thomasschoenfeld/GoBe/Cage_Plate_VZHex_v2.stl

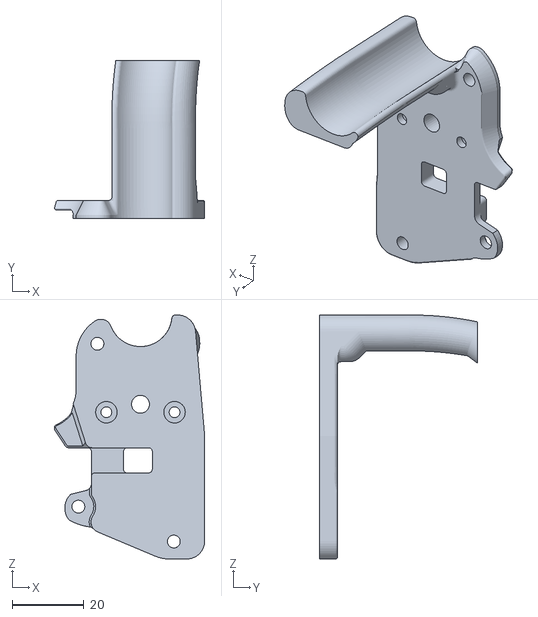
[picture p17: CAD file, 2024-02-20]
Cage_Plate_VZHex_v2.stl
41.9 x 44.0 x 68.0
