thomasschoenfeld/GoBe/GoBe_toolead_v1.9.1.stl

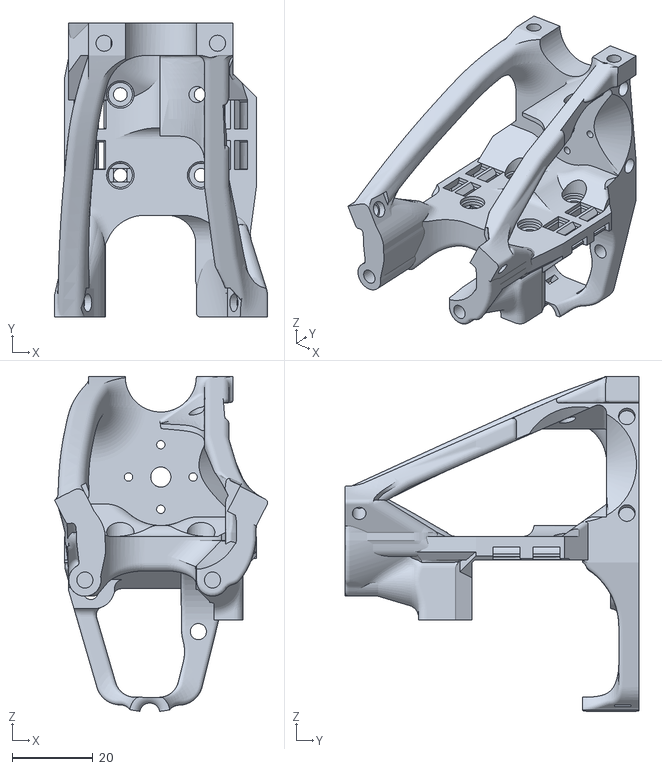
[picture p18: CAD file, 2024-02-20]
GoBe_toolead_v1.9.1.stl
52.8 x 72.8 x 82.9
