thomasschoenfeld/GoBe/Cage_Umbilical_v2.1.stl

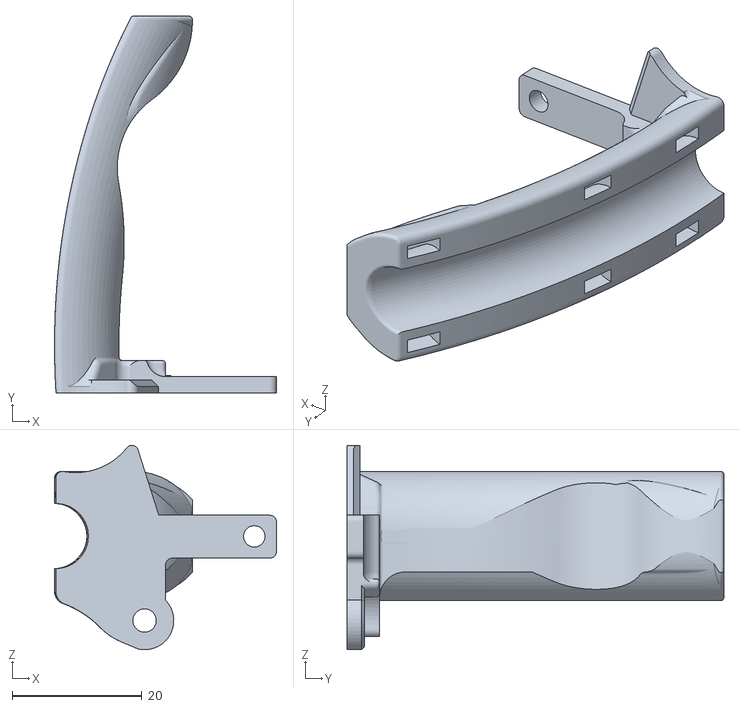
[picture p19: CAD file, 2024-02-20]
Cage_Umbilical_v2.1.stl
34.2 x 58.0 x 31.4
