thomasschoenfeld/GoBe/GoBe_toolead_v1.9.0_wKlicky_and_support.stl

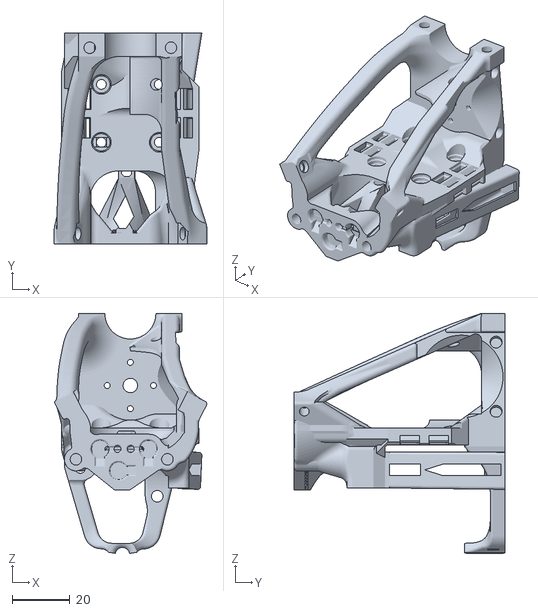
[picture p20: CAD file, 2023-03-26]
GoBe_toolead_v1.9.0_wKlicky_and_support.stl
52.8 x 72.8 x 82.9
