thomasschoenfeld/GoBe/GoBe_toolead_v1.9.0_w_Klicky_support_required.stl

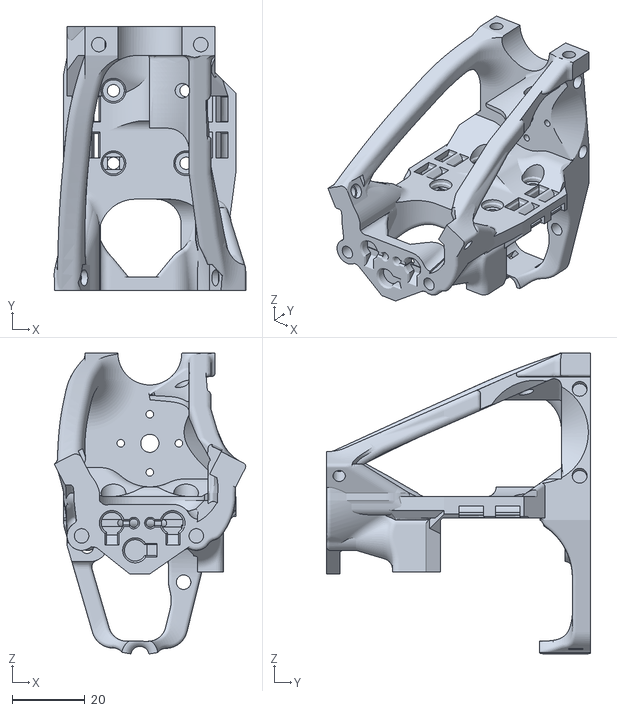
[picture p21: CAD file, 2023-03-26]
GoBe_toolead_v1.9.0_w_Klicky_support_required.stl
52.8 x 72.8 x 82.9
