thomasschoenfeld/GoBe/Hex_Cage_Support_v2.stl

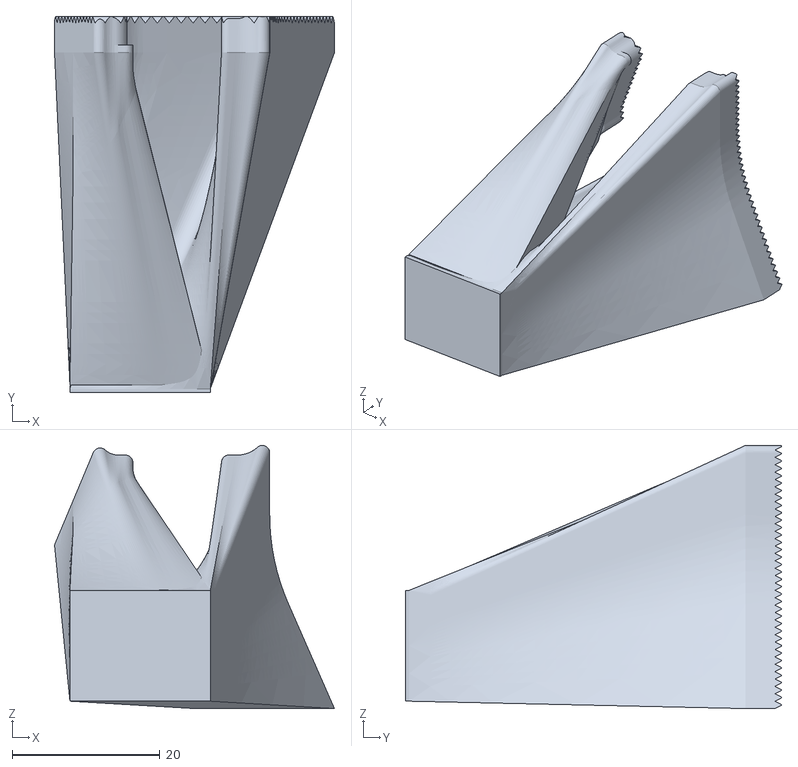
[picture p22: CAD file, 2023-03-26]
Hex_Cage_Support_v2.stl
37.9 x 50.9 x 35.6
