thomasschoenfeld/GoBe/Hex_adapter_w_cage.stl

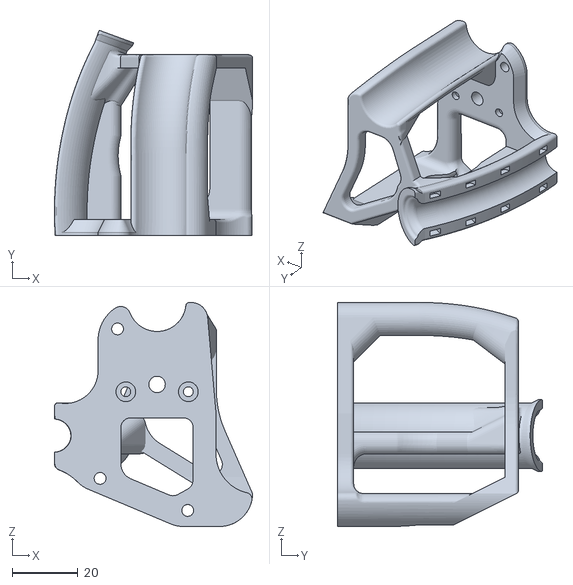
[picture p23: CAD file, 2023-03-25]
Hex_adapter_w_cage.stl
60.2 x 62.4 x 68.0
