thomasschoenfeld/GoBe/HEx-adapter_v3.1.stl

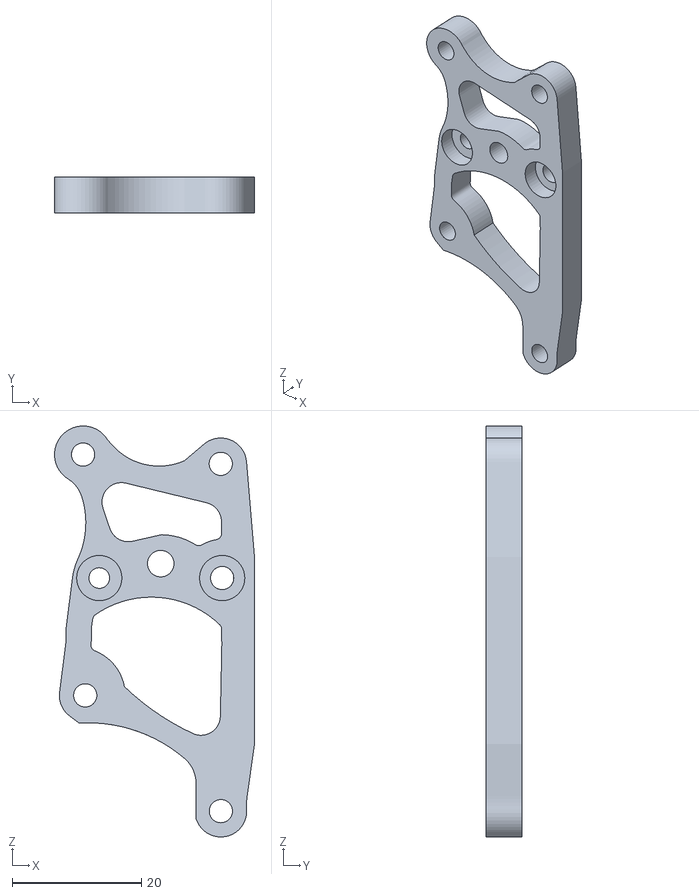
[picture p24: CAD file, 2023-03-23]
HEx-adapter_v3.1.stl
30.9 x 5.50 x 63.5
