thomasschoenfeld/GoBe/GoBe_toolead_v1.8.2_wSupport.stl

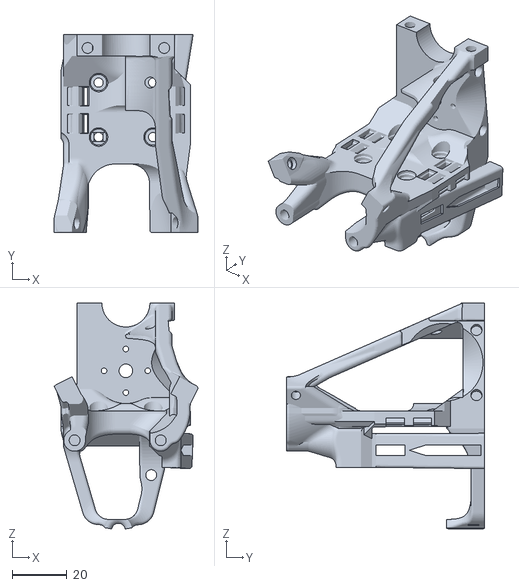
[picture p25: CAD file, 2023-03-23]
GoBe_toolead_v1.8.2_wSupport.stl
52.8 x 72.8 x 82.9
