thomasschoenfeld/GoBe/Duct_v6.3.stl

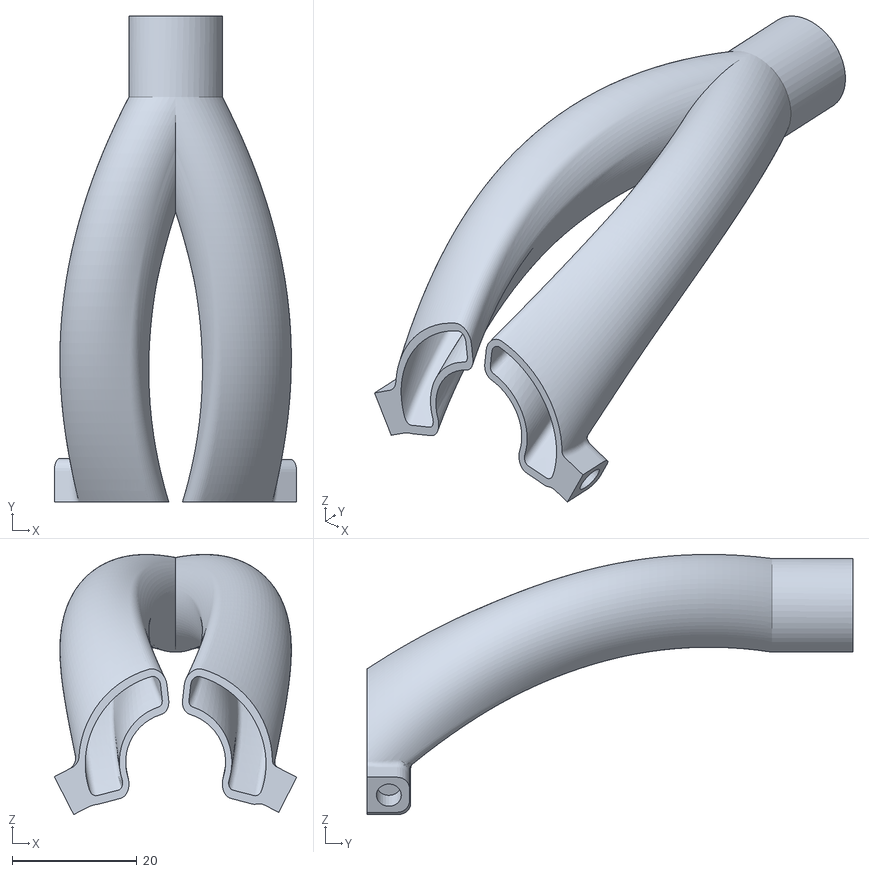
[picture p26: CAD file, 2023-03-20]
Duct_v6.3.stl
38.8 x 77.8 x 41.6
