thomasschoenfeld/GoBe/GoBe_toolead_v1.7_Voron2.4 CF rod MOD v71_HEx-adapter_v2.stl

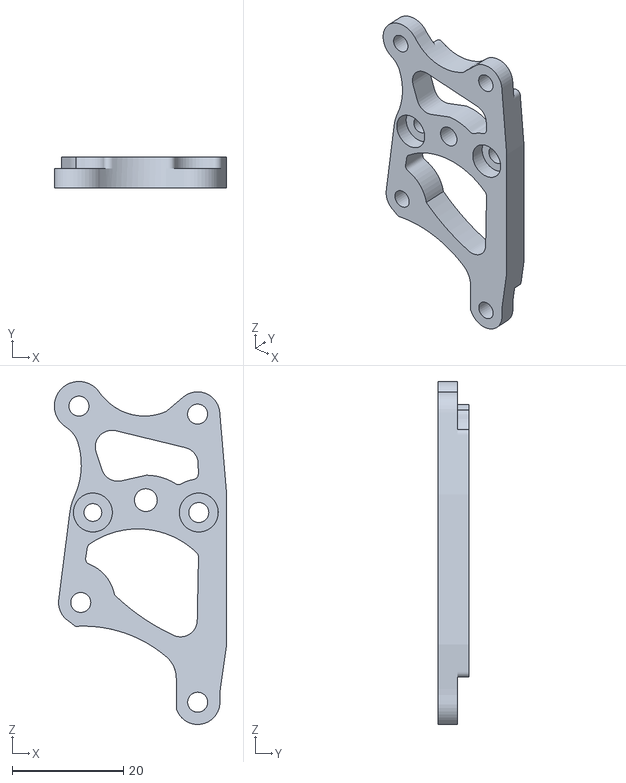
[picture p27: CAD file, 2023-03-19]
GoBe_toolead_v1.7_Voron2.4 CF rod MOD v71_HEx-adapter_v2.stl
30.9 x 5.50 x 61.5
