thomasschoenfeld/GoBe/GoBe_toolead_v1.7_Voron2.4 CF rod MOD v71_Umbilical_cord_3.0.stl

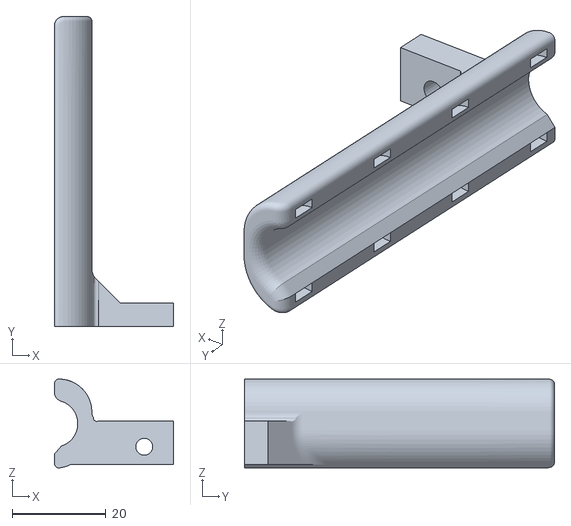
[picture p28: CAD file, 2023-03-19]
GoBe_toolead_v1.7_Voron2.4 CF rod MOD v71_Umbilical_cord_3.0.stl
25.4 x 66.0 x 18.9
