thomasschoenfeld/GoBe/Goliath_FYI.stl

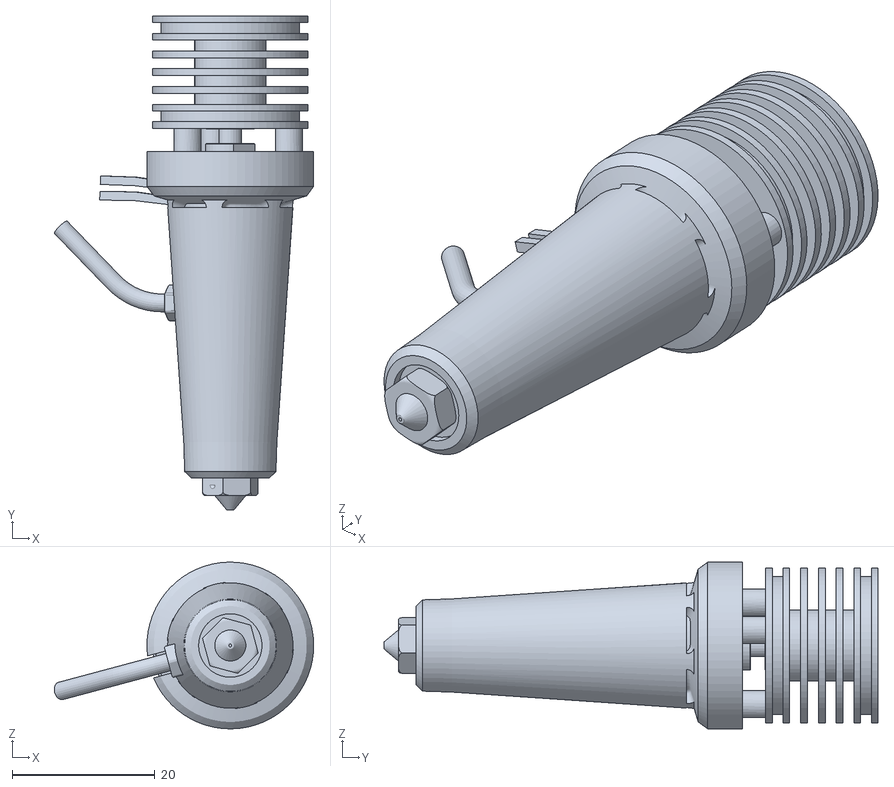
[picture p29: CAD file, 2023-03-19]
Goliath_FYI.stl
36.4 x 69.3 x 23.4
