thomasschoenfeld/GoBe/Clamp_v3.0.stl

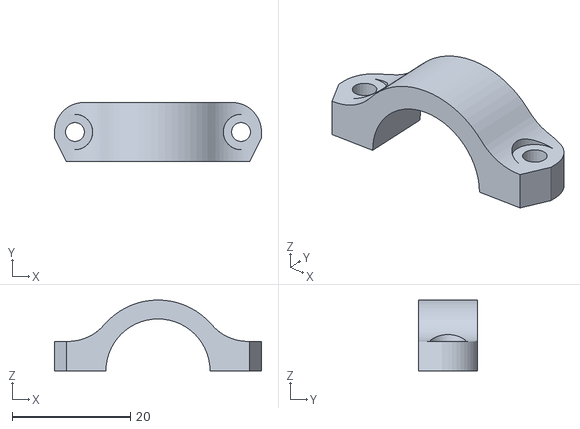
[picture p30: CAD file, 2023-03-19]
Clamp_v3.0.stl
35.0 x 10.0 x 12.0
