thomasschoenfeld/GoBe/(list of files, cad)

Other CAD files:
GoBe_toolead_v1.9.0_w_support.stl
older_version/GoBe_toolead_v1.8.1_w_support.stl
GoBe_toolead_v1.8.1_w_support.stl
GoBe_toolead_v1.8.2.stl
GoBe_toolead_v1.9.0.stl
older_version/Clamp_4.1_w_ADXL_mount.stl
older_version/Clamp_w_ADXL_mount.stl
older_version/GoBe_toolead_v1.3.stl
older_version/GoBe_toolead_v1.6.stl
older_version/GoBe_toolead_v1.7_Voron2.4 CF rod MOD v71_GoBe_toolead_v1.7.stl
older_version/GoBe_toolead_v1.7_Voron2.4 CF rod MOD v71_Klicky_toolhead_v1.7.stl
older_version/GoBe_toolead_v1.8.2.stl
older_version/GoBe_toolhead_v1.0_Voron2.4 CF rod MOD v18_3010_fan.stl
older_version/GoBe_toolhead_v1.0_Voron2.4 CF rod MOD v18_Clamp_3.0.stl
older_version/GoBe_toolhead_v1.0_Voron2.4 CF rod MOD v18_DUCT_v5.5.stl
older_version/GoBe_toolhead_v1.0_Voron2.4 CF rod MOD v18_GoBe_toolead_v1.1.stl
older_version/GoBe_toolhead_v1.0_Voron2.4 CF rod MOD v18_Goliath.stl
older_version/GoBe_toolhead_v1.0_Voron2.4 CF rod MOD v18_HEx-adapter_v2.stl
older_version/GoBe_toolhead_v1.0_Voron2.4 CF rod MOD v18_Umbilical_cord_3.0.stl
