thomasschoenfeld/GoBe/(commit log)

2023-03-16 toolhead updated
    [GoBe_toolhead_v1.0_Voron2.4 CF rod MOD v18_3010_fan.stl, GoBe_toolhead_v1.0_Voron2.4 CF rod MOD v18_Clamp_3.0.stl, GoBe_toolhead_v1.0_Voron2.4 CF rod MOD v18_DUCT_v5.5.stl, GoBe_toolhead_v1.0_Voron2.4 CF rod MOD v18_GoBe_toolead_v1.1.stl, GoBe_toolhead_v1.0_Voron2.4 CF rod MOD v18_Goliath.stl, GoBe_toolhead_v1.0_Voron2.4 CF rod MOD v18_HEx-adapter_v2.stl, GoBe_toolhead_v1.0_Voron2.4 CF rod MOD v1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]
2023-03-16 modified geometry
    [GoBe_toolead_v1.3.stl]
2023-03-19 improver version
    [Clamp_4.1_w_ADXL_mount.stl, Clamp_w_ADXL_mount.stl, GoBe_toolead_v1.3.stl, GoBe_toolead_v1.6.stl, GoBe_toolead_v1.7_Voron2.4 CF rod MOD v71_3010_fan.stl, GoBe_toolead_v1.7_Voron2.4 CF rod MOD v71_Clamp_3.0.stl, GoBe_toolead_v1.7_Voron2.4 CF rod MOD v71_Clamp_4.1_w_ADXL_mount.stl, GoBe_toolead_v1.7_Voron2.4 CF rod MOD v71_DUCT_v6.0.stl]
2023-03-20 improved hotend cooling
    [GoBe_toolead_v1.7.1.stl, Klicky_toolhead_v1.7.1.stl]
2023-03-20 updated hotend cooling
    [GoBe_toolead_v1.7_Voron2.4 CF rod MOD v71_GoBe_toolead_v1.7.stl, GoBe_toolead_v1.7_Voron2.4 CF rod MOD v71_Klicky_toolhead_v1.7.stl]
2023-03-20 slightly updated duct
    [Duct_v6.3.stl, GoBe_toolead_v1.7.1.stl, GoBe_toolead_v1.7.2.stl, GoBe_toolead_v1.7_Voron2.4 CF rod MOD v71_DUCT_v6.0.stl, Klicky_toolhead_v1.7.1.stl, Klicky_toolhead_v1.7.2.stl]
2023-03-20 added print support structures
    [GoBe_klicky_v1.7.3_w_print_support.stl, GoBe_toolead_v1.7.2.stl, GoBe_toolead_v1.7.3.stl, GoBe_toolead_v1.7.3_with_support.stl, Klicky_toolhead_v1.7.2.stl, Klicky_toolhead_v1.7.3.stl]
2023-03-23 v1.8 with multiple improvements
    [GoBe_toolead_v1.8.1_w_support.stl, GoBe_toolead_v1.8.2.stl, GoBe_toolead_v1.8.2_wSupport.stl, HEx-adapter_v3.1.stl]
2023-03-23 uploaded fusion file
    [GoBe_klicky_v1.7.3_w_print_support.stl, GoBe_toolead_v1.7.3.stl, GoBe_toolead_v1.7.3_with_support.stl, Klicky_toolhead_v1.7.3.stl]
2023-03-25 stronger top cage added
    [GoBe_toolead_v1.7_Voron2.4 CF rod MOD v71_Clamp_4.1_w_ADXL_mount.stl, GoBe_toolead_v1.9.0.stl, GoBe_toolead_v1.9.0_w_support.stl, Hex_Cage_Support1.stl, Hex_adapter_w_cage.stl]
2023-03-25 updates readme and pictures
    [Clamp_v3.0.stl, GoBe_toolead_v1.7_Voron2.4 CF rod MOD v71_3010_fan.stl, GoBe_toolead_v1.7_Voron2.4 CF rod MOD v71_HEx-adapter_v2.stl, GoBe_toolead_v1.7_Voron2.4 CF rod MOD v71_Umbilical_cord_3.0.stl, Goliath_FYI.stl]
2023-03-26 cleanup and STL for Klicky with and without supports
    [GoBe_toolead_v1.8.1_w_support.stl, GoBe_toolead_v1.8.2.stl, GoBe_toolead_v1.8.2_wSupport.stl, GoBe_toolead_v1.9.0_w_Klicky_support_required.stl, HEx-adapter_v3.1.stl, Hex_Cage_Support1.stl, Hex_Cage_Support_v2.stl]
2023-03-26 easier to remove support for klicky version
    [GoBe_toolead_v1.9.0_wKlicky_and_support.stl]
2024-02-20 updated cage
    updated simplified cage and umbilical
    [Cage_Plate_VZHex_v2.stl, Cage_Umbilical_v2.1.stl, GoBe_toolead_v1.9.1.stl]
